AKAndrew/Counter_Intrusion_System_Arduino/README.md

# Counter_Intrusion_System_Arduino
A device that detects motion and can trigger an alarm if it is armed. Once armed records detected movements on internel chip and the logs can be downloaded on a Windows machine. C/C++ Arduino project
